LDSEmbarcatech25/emb2-monitoramento-servidor/COMPONENTES CAIXA v3/Impressão 3D/3_tampa_KiiRA_v2.stl

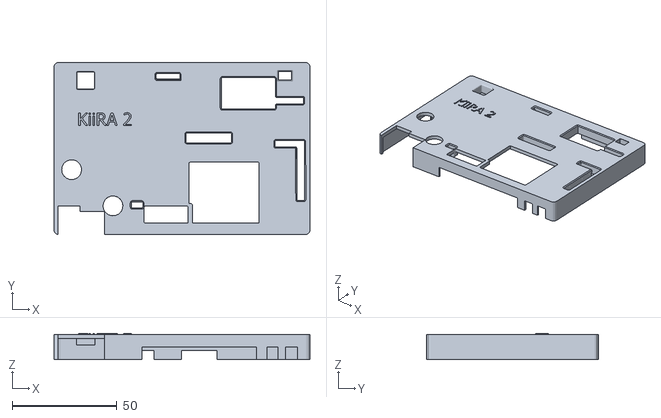
[picture p1: CAD file, 2026-06-12]
COMPONENTES CAIXA v3/Impressão 3D/3_tampa_KiiRA_v2.stl
122.0 x 82.0 x 12.5
