LDSEmbarcatech25/emb2-monitoramento-servidor/Impressão 3D/3_tampa_KiiRA_v2.stl

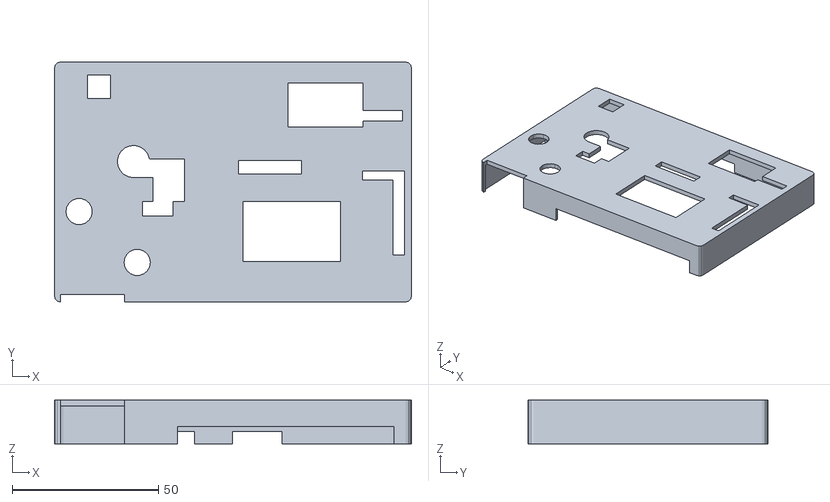
[picture p3: CAD file, 2026-06-09, an earlier design]
Impressão 3D/3_tampa_KiiRA_v2.stl
122.0 x 82.0 x 15.0
