LDSEmbarcatech25/emb2-monitoramento-servidor/Impressão 3D/2_caixa_KiiRA_v2.stl

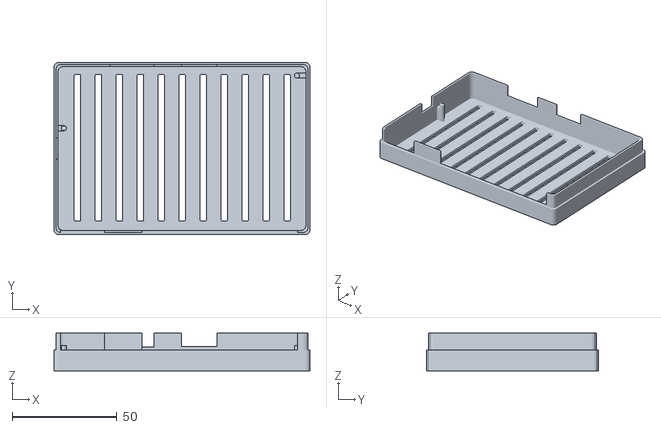
[picture p4: CAD file, 2026-06-09, an earlier design]
Impressão 3D/2_caixa_KiiRA_v2.stl
122.0 x 82.0 x 18.0
