LDSEmbarcatech25/emb2-monitoramento-servidor/(list of files, cad)

Other CAD files:
3D_PCB2_2026-05-22.iam
COMPONENTES CAIXA v3/1_placa_KiiRA-3D.iam
COMPONENTES CAIXA v3/2_caixa_KiiRA_v2.ipt
COMPONENTES CAIXA v3/3_tampa_KiiRA_v2.ipt
COMPONENTES CAIXA v3/MontagemCASE.iam
COMPONENTES CAIXA v3/OldVersions/1_placa_KiiRA_desenho.0003.idw
COMPONENTES CAIXA v3/OldVersions/2_caixa_KiiRA_v2.0106.ipt
COMPONENTES CAIXA v3/OldVersions/3_tampa_KiiRA_v2.0557.ipt
COMPONENTES CAIXA v3/OldVersions/MontagemCASE.0106.iam
