LDSEmbarcatech25/emb2-monitoramento-servidor/camera_arquivos/camera-api-tutorial.pdf

## Adicionando o binário personalizado na placa

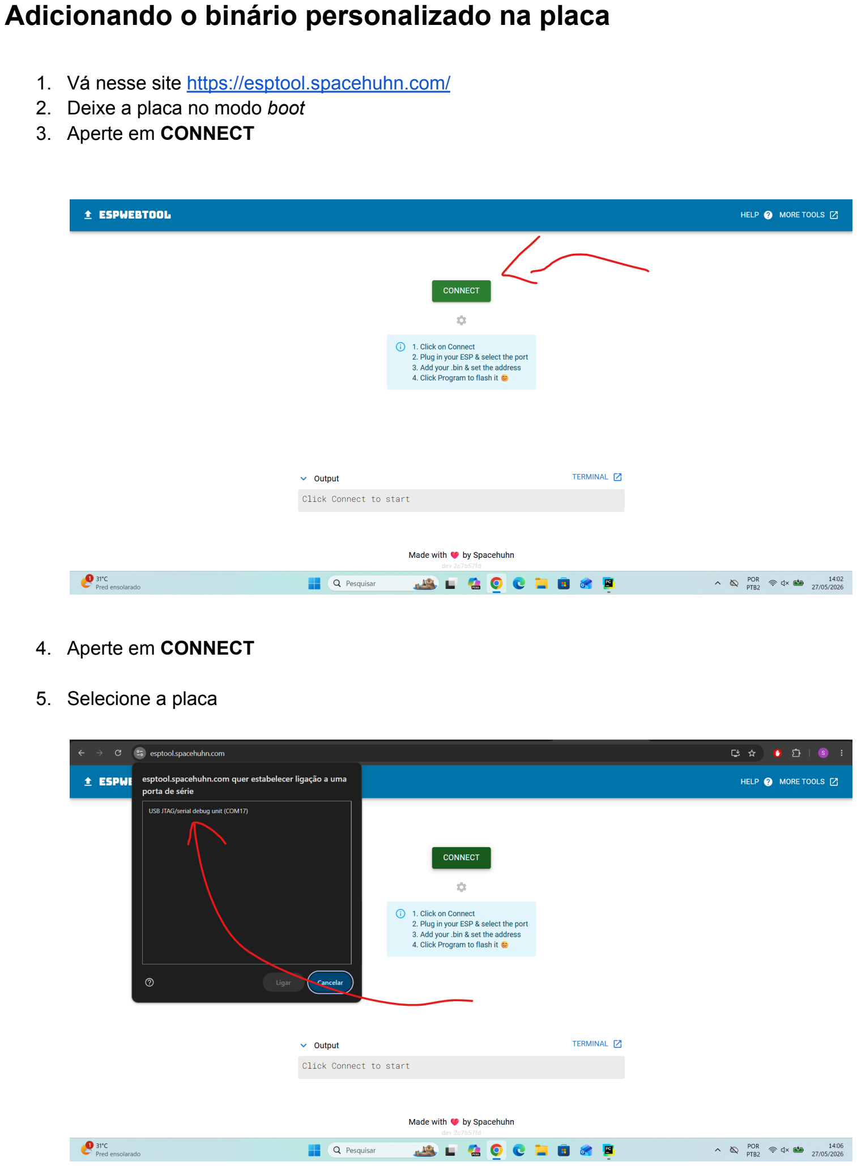
[picture p5: page 1]

1. Vá nesse site https://esptool.spacehuhn.com/
2. Deixe a placa no modo boot
3. Aperte em CONNECT
4. Aperte em CONNECT
5. Selecione a placa

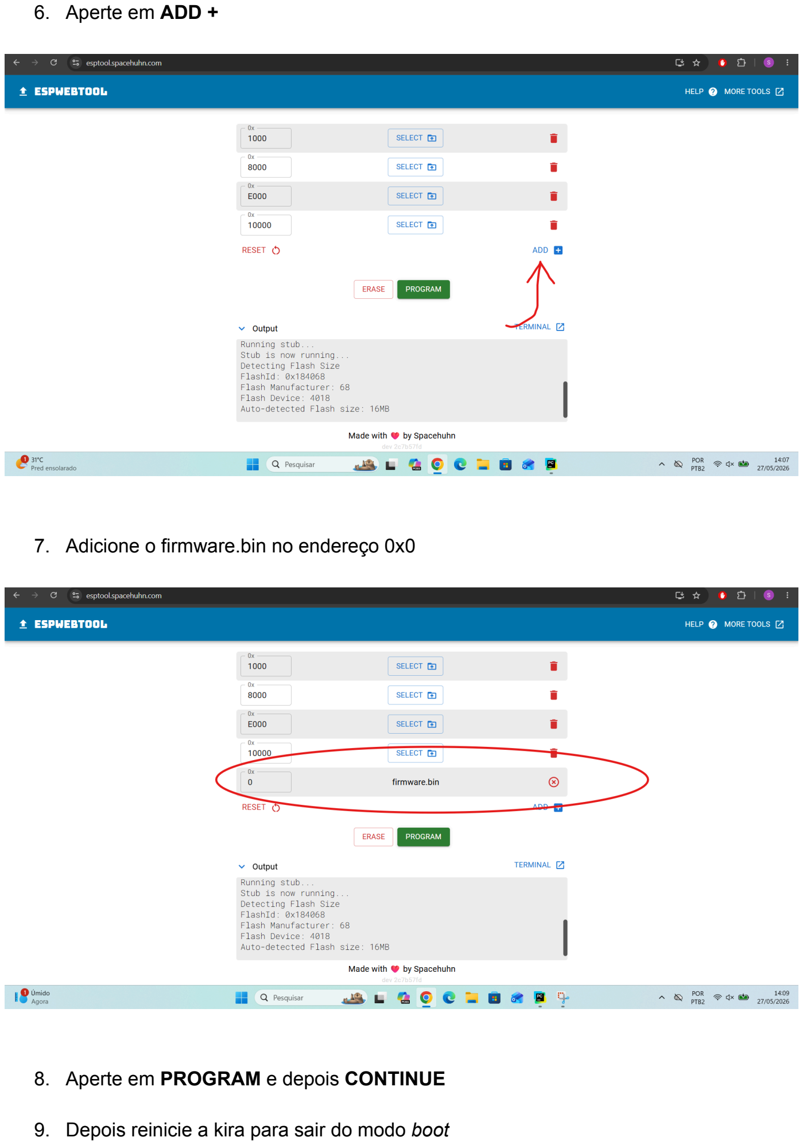
[picture p6: page 2]

6. Aperte em ADD +
7. Adicione o firmware.bin no endereço 0x0
8. Aperte em PROGRAM e depois CONTINUE
9. Depois reinicie a kira para sair do modo boot

## Tirando Foto

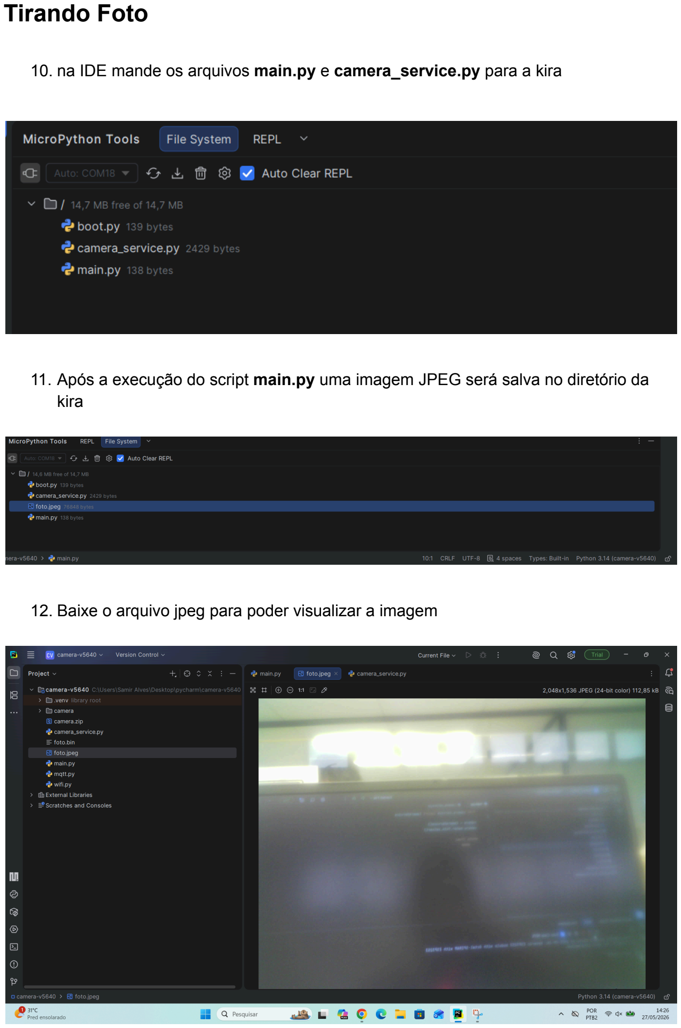
[picture p7: page 3]

10. na IDE mande os arquivos main.py e camera_service.py para a kira
11. Após a execução do script main.py uma imagem JPEG será salva no diretório da kira
12. Baixe o arquivo jpeg para poder visualizar a imagem
