LDSEmbarcatech25/emb2-monitoramento-servidor/arquivos_SSD1306_MQTT/umqttsimple.py

# Driver Oficial MicroPython uMQTT Simple - CORRIGIDO
import usocket as socket
import ustruct as struct
from ubinascii import hexlify

class MQTTException(Exception): pass

class MQTTClient:
    def __init__(self, client_id, server, port=0, user=None, password=None, keepalive=0, ssl=False, ssl_params={}):
        if port == 0: port = 8883 if ssl else 1883
        self.client_id = client_id; self.sock = None; self.server = server; self.port = port
        self.ssl = ssl; self.ssl_params = ssl_params; self.pid = 0; self.cb = None
        self.user = user; self.pswd = password; self.keepalive = keepalive; self.lw_topic = None
        self.lw_msg = None; self.lw_qos = 0; self.lw_retain = False

    def _send_str(self, s): self.sock.write(struct.pack("!H", len(s))); self.sock.write(s)
    def _recv_len(self):
        n = 0; sh = 0
        while 1:
            b = self.sock.read(1)[0]
            n |= (b & 0x7F) << sh
            if not b & 0x80: return n
            sh += 7

    def set_callback(self, f): self.cb = f
    def set_last_will(self, topic, msg, retain=False, qos=0): self.lw_topic = topic; self.lw_msg = msg; self.lw_retain = retain; self.lw_qos = qos

    def connect(self, clean_session=True):
        self.sock = socket.socket()
        addr = socket.getaddrinfo(self.server, self.port)[0][-1]
        self.sock.connect(addr)
        if self.ssl: import ussl; self.sock = ussl.wrap_socket(self.sock, **self.ssl_params)
        premsg = bytearray(b"\x10\0\0\4MQTT\x04\x02\0\0")
        sz = 10 + 2 + len(self.client_id)
        if self.user: sz += 2 + len(self.user) + 2 + len(self.pswd)
        if self.lw_topic: sz += 2 + len(self.lw_topic) + 2 + len(self.lw_msg)
        if not clean_session: premsg[7] &= 0xFD
        if self.user: premsg[7] |= 0xC0
        if self.lw_topic: premsg[7] |= 0x04 | (self.lw_qos & 3) << 3
        if self.lw_retain: premsg[7] |= 0x20
        premsg[9] = self.keepalive
        struct.pack_into("!H", premsg, 2, sz)
        self.sock.write(premsg)
        self._send_str(self.client_id)
        if self.lw_topic: self._send_str(self.lw_topic); self._send_str(self.lw_msg)
        if self.user: self._send_str(self.user); self._send_str(self.pswd)
        resp = self.sock.read(4)
        assert resp[0] == 0x20 and resp[1] == 0x02
        if resp[3] != 0: raise MQTTException(resp[3])
        return resp[2] & 1

    def disconnect(self): self.sock.write(b"\xe0\0"); self.sock.close()
    def ping(self): self.sock.write(b"\xc0\0")

    def publish(self, topic, msg, retain=False, qos=0):
        pkt = bytearray(b"\x30\0\0\0")
        if retain: pkt[0] |= 1
        if qos > 0: pkt[0] |= qos << 1
        sz = 2 + len(topic) + len(msg)
        if qos > 0: sz += 2
        assert sz < 2097152
        i = 1
        while sz > 0x7F: pkt.insert(i, (sz & 0x7F) | 0x80); sz >>= 7; i += 1
        pkt[i] = sz; self.sock.write(pkt[:i+1]); self._send_str(topic)
        if qos > 0: self.pid += 1; struct.pack_into("!H", pkt, 0, self.pid); self.sock.write(pkt[:2])
        self.sock.write(msg)

    def subscribe(self, topic, qos=0):
        """Assina um tópico específico para começar a escutar as mensagens."""
        assert self.cb is not None
        self.pid += 1
        pkt = bytearray(struct.pack("!HH", self.pid, len(topic)))
        self.sock.write(struct.pack("!BB", 0x82, len(pkt) + len(topic) + 1))
        self.sock.write(pkt); self.sock.write(topic); self.sock.write(struct.pack("B", qos))
        resp = self.sock.read(5)
        assert resp[0] == 0x90 and resp[1] == 3 and resp[2] == pkt[0] and resp[3] == pkt[1]

    def check_msg(self):
        """Verifica de forma não-bloqueante se chegaram novas mensagens do Broker."""
        self.sock.setblocking(False)
