LDSEmbarcatech25/emb2-monitoramento-servidor/(commit log)

2026-05-27 atualizações de dados e informações
2026-06-03 Add initial Arduino code for KiiRA v2.0 project
    Initial commit of the KiiRA v2.0 project with complete Arduino code for IoT functionalities including camera handling, MQTT integration, and web server setup.
2026-06-03 arquivos para MQTT
2026-06-03 Passo a passo para compilar o codigo no VScode
2026-06-03 Add main_semcamera for remote monitoring project
    Implement main functionality for remote monitoring using MQTT and I2C display.
2026-06-03 arquivos camera
2026-06-08 Update fmt.Println message from 'Hello' to 'Goodbye'
2026-06-08 Adicionar CameraService para captura de imagens
    Implementa o serviço de câmera com métodos para captura e salvamento de fotos.
2026-06-08 Add SSD1306 OLED display driver in MicroPython
    This file contains the official MicroPython driver for the SSD1306 OLED display, implementing I2C communication and various drawing functions.
2026-06-09 Fix typo in print statement
    [main_oficial.py]
